Mo-SW-Dev/CalliopeMiniV2/Calliope mini rev2.0-2.1/Documentation/Datenblatt-PCB Calliope mini rev2.0.PDF

Fbl.1001-02 Kunden-Datenblatt-Leiterplatte

# Kunden-Datenblatt-Leiterplatte

### Data Sheet - PCB

### Stand: 10.02.2015

Bezeichnung / Name:
LP-Nr. / Board-Nr: Calliope mini | Bezeichnung / Name: Rev: 2.0
Art.-Nr.: DI.007.0020.0 | Datei / File: | HWB

Basis-Material / Ausführung / Laminat:
[x] FR4 | [ ] Polyimid | [ ] FR4 / Polyimid | [ ] TG:
[ ] starr / rigid | [ ] flex | [ ] starr-flex / rigid-flex | [ ] semiflex
LP-Dicke / board thicknes: | [ ] 1,0mm | [x] 1,6mm | [ ] 2,0mm | [ ] 2,4mm
Lagenzahl / Layer counts: | [ ] 1-lagig / layer | [x] 2-lagig / layers | -lagig /
[ ] layers

[ ] Signalleitungen auf Innenlagen / Signal lines on the inside
SMD-Best. / SMD-Pads: | [x] BS | [ ] LS | [ ] ohne / without
Remark : ( BS = component side = top ) ( LS = solder side = bottom ) Mechanik / Maße / Mechanic / Diameter:
[ ] Einzelplatine / single board | [x] Nutzen- 6 | fach / panel - fold | [ ] Bohrungen / drillings:
[x] gefräst / milling | [ ] geritzt / scoring
Maße Einzel / Nutzen Diameter Single / Panel 85.5 | x 75.3 | / 280.62 | x 172.24 | mm

Metallisierung (Endstärke) / Plating thickness (final thickness):
Kupfer-Endstärke / Copper thickness layer: | [x] ≥ 35µ
Kupfer-Hülse / plated through holes: | [x] ≥ 20µ

Oberfläche, Lack / Finish:
[ ] HAL bleifrei | [ ] ch. Sn ≥ 0,08µ | [x] ch. NiAu ≥ 0,05µ Au | [ ] galv. NiAu ≥ 1,27µ Au Sideplating
Lötstoplack / Soldermask: | [x] BS | [x] LS | Farbe / Colour: Blau | [ ] ohne / without
Bestückungsdruck / Component notation: | [x] BS | [x] LS | Farbe / Colour: Weiß | [ ] ohne / without
Via-Druck luftdicht / Via closed: | [ ] BS | [ ] LS | [x] ohne / without
Abdeckmaske abziehbar / Peelable mask: | [ ] BS | [ ] LS | [x] ohne / without

Prüfungen / Checks:
Leiterbild / Layout: | [x] Sichtkontrolle | [ ] AOI | [x] Elektr.-Test / electrical checks,
Kennzeichnung:
Sonstiges / other: | [ ] Schliff (bild) | [ ] Impedanzen,

Klassifizierung / Classifikation:
Leiterbreite / -abstand (µ) / kleinste Bohrung End-∅ (mm) / Lines width / -distance (µ) / smallest hole - final diameter (mm)
[ ] K1 (Normal: ≥ 8mil / 0,4mm) | [ ] K2 (Fein: ≥ 6mil / 0,3mm) | [ ] K3 (Feinst: ≥ 5mil / 0,2mm) ≥ 3mil / 0,1mm

[x] UL-Kennzeichnung und Datumskodierung / UL-marking and Date-Code

| Erstellt / made | | Geprüft / checked | | Freigegeben / released
Datum / Date: 13.06.2019 | | Datum / Date: | | Datum / Date:
Name: W. Grünwald | | Name: | | Name:

Bemerkungen / Remarks:
