Mo-SW-Dev/CalliopeMiniV2/Calliope mini rev2.0-2.1/revision Bitmap/Nummerierung.bmp

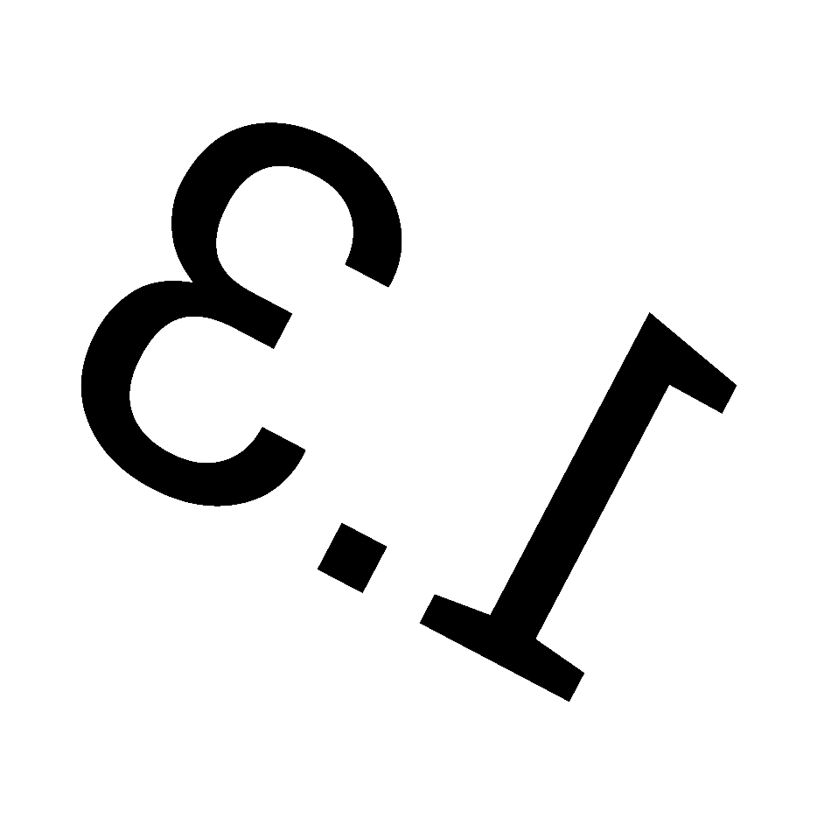
Calliope mini rev2.0-2.1/revision Bitmap/Nummerierung.bmp
