Mo-SW-Dev/CalliopeMiniV2/Calliope mini rev2.0-2.1/Silkscreen Bitmaps/Calliope_mini_1_3_Front.bmp

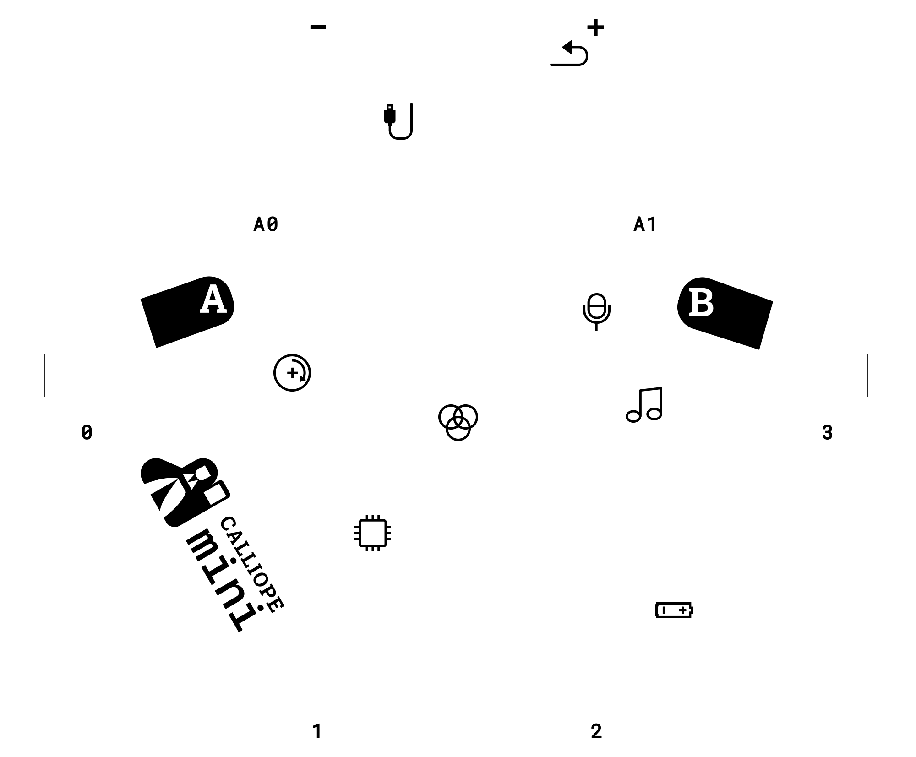
Calliope mini rev2.0-2.1/Silkscreen Bitmaps/Calliope_mini_1_3_Front.bmp
