Mo-SW-Dev/CalliopeMiniV2/Calliope mini rev2.0-2.1/Silkscreen Bitmaps/Calliope_mini_2_0_Back_VORLAGE.png

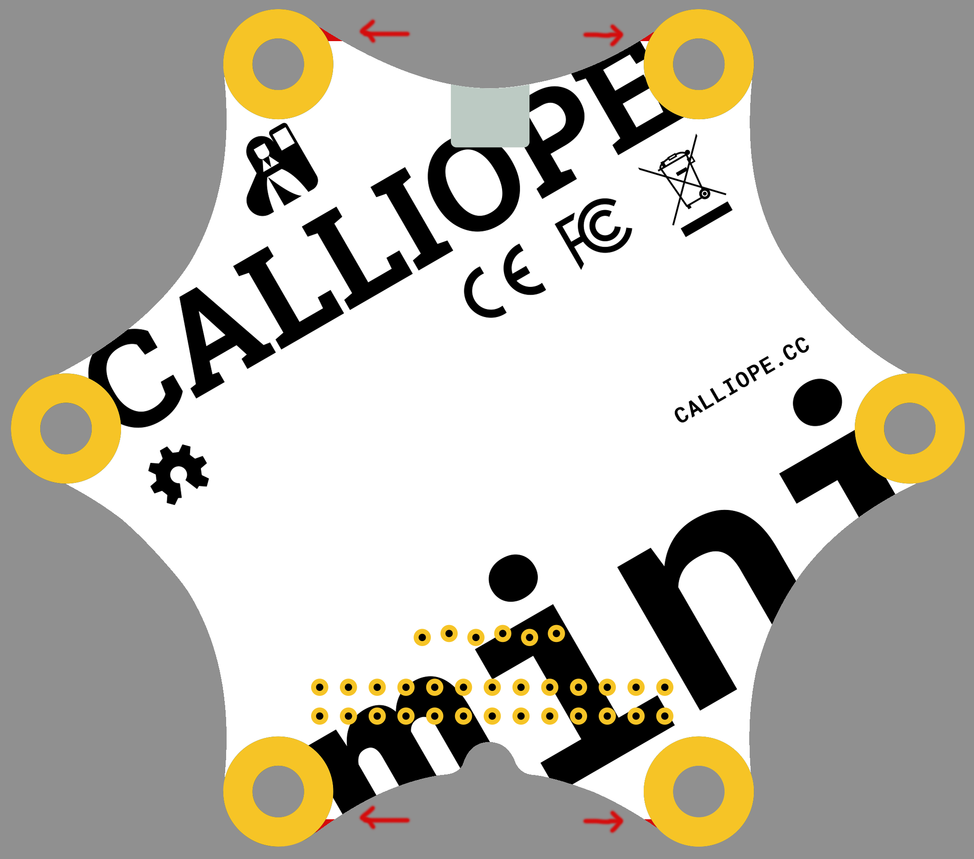
Calliope mini rev2.0-2.1/Silkscreen Bitmaps/Calliope_mini_2_0_Back_VORLAGE.png
