Mo-SW-Dev/CalliopeMiniV2/Calliope mini rev2.0-2.1/Documentation/CalliopeMiniRev2.0_TopAssembly.pdf

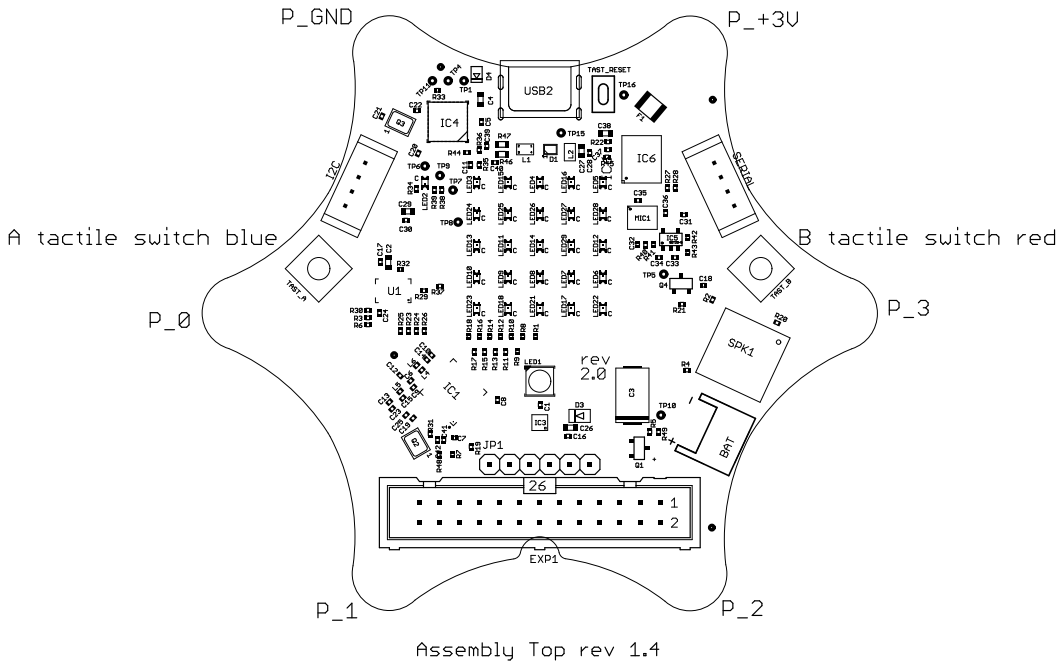
[picture p7: page 1]
