Mo-SW-Dev/CalliopeMiniV2/Calliope mini rev2.0-2.1/Documentation/CalliopeMiniRev2.0_BottomSilkscreen.pdf

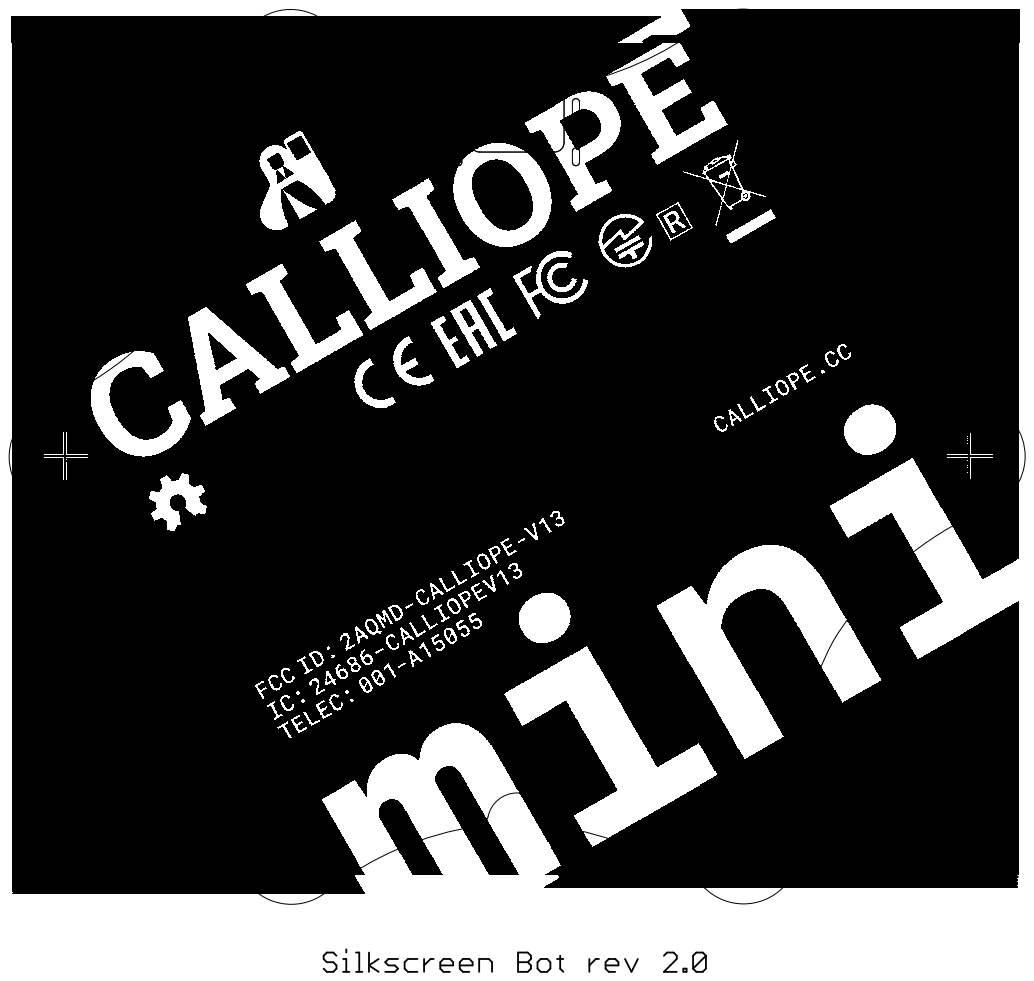
[picture p9: page 1]
