Mo-SW-Dev/CalliopeMiniV2/Calliope mini rev2.0-2.1/Documentation/CalliopeMiniRev2.0_BottomStop.pdf

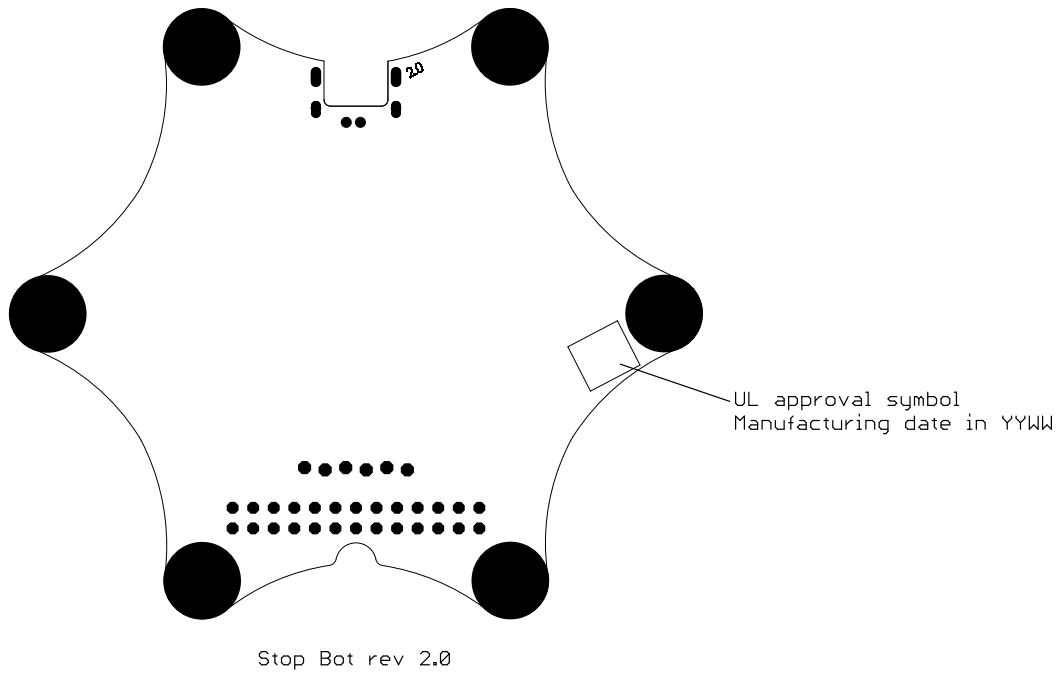
[picture p10: page 1]
