Mo-SW-Dev/CalliopeMiniV2/Calliope mini rev2.0-2.1/Documentation/CalliopeMiniRev2.0_TopSilkscreen.pdf

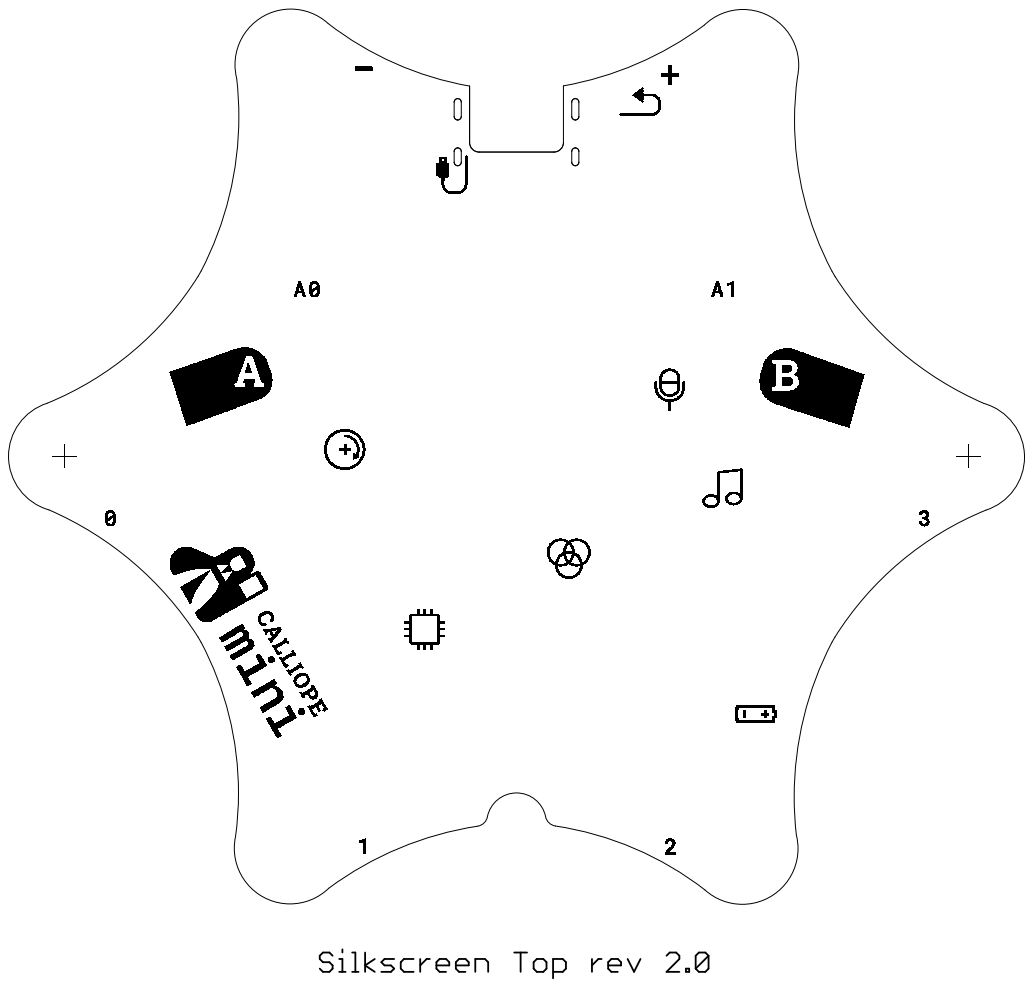
[picture p14: page 1]
