Mo-SW-Dev/CalliopeMiniV2/Calliope mini rev2.0-2.1/Calliope mini rev2.0.1.brd

## EAGLE design Calliope mini rev2.0-2.1/Calliope mini rev2.0.1.brd (2019-08-05)

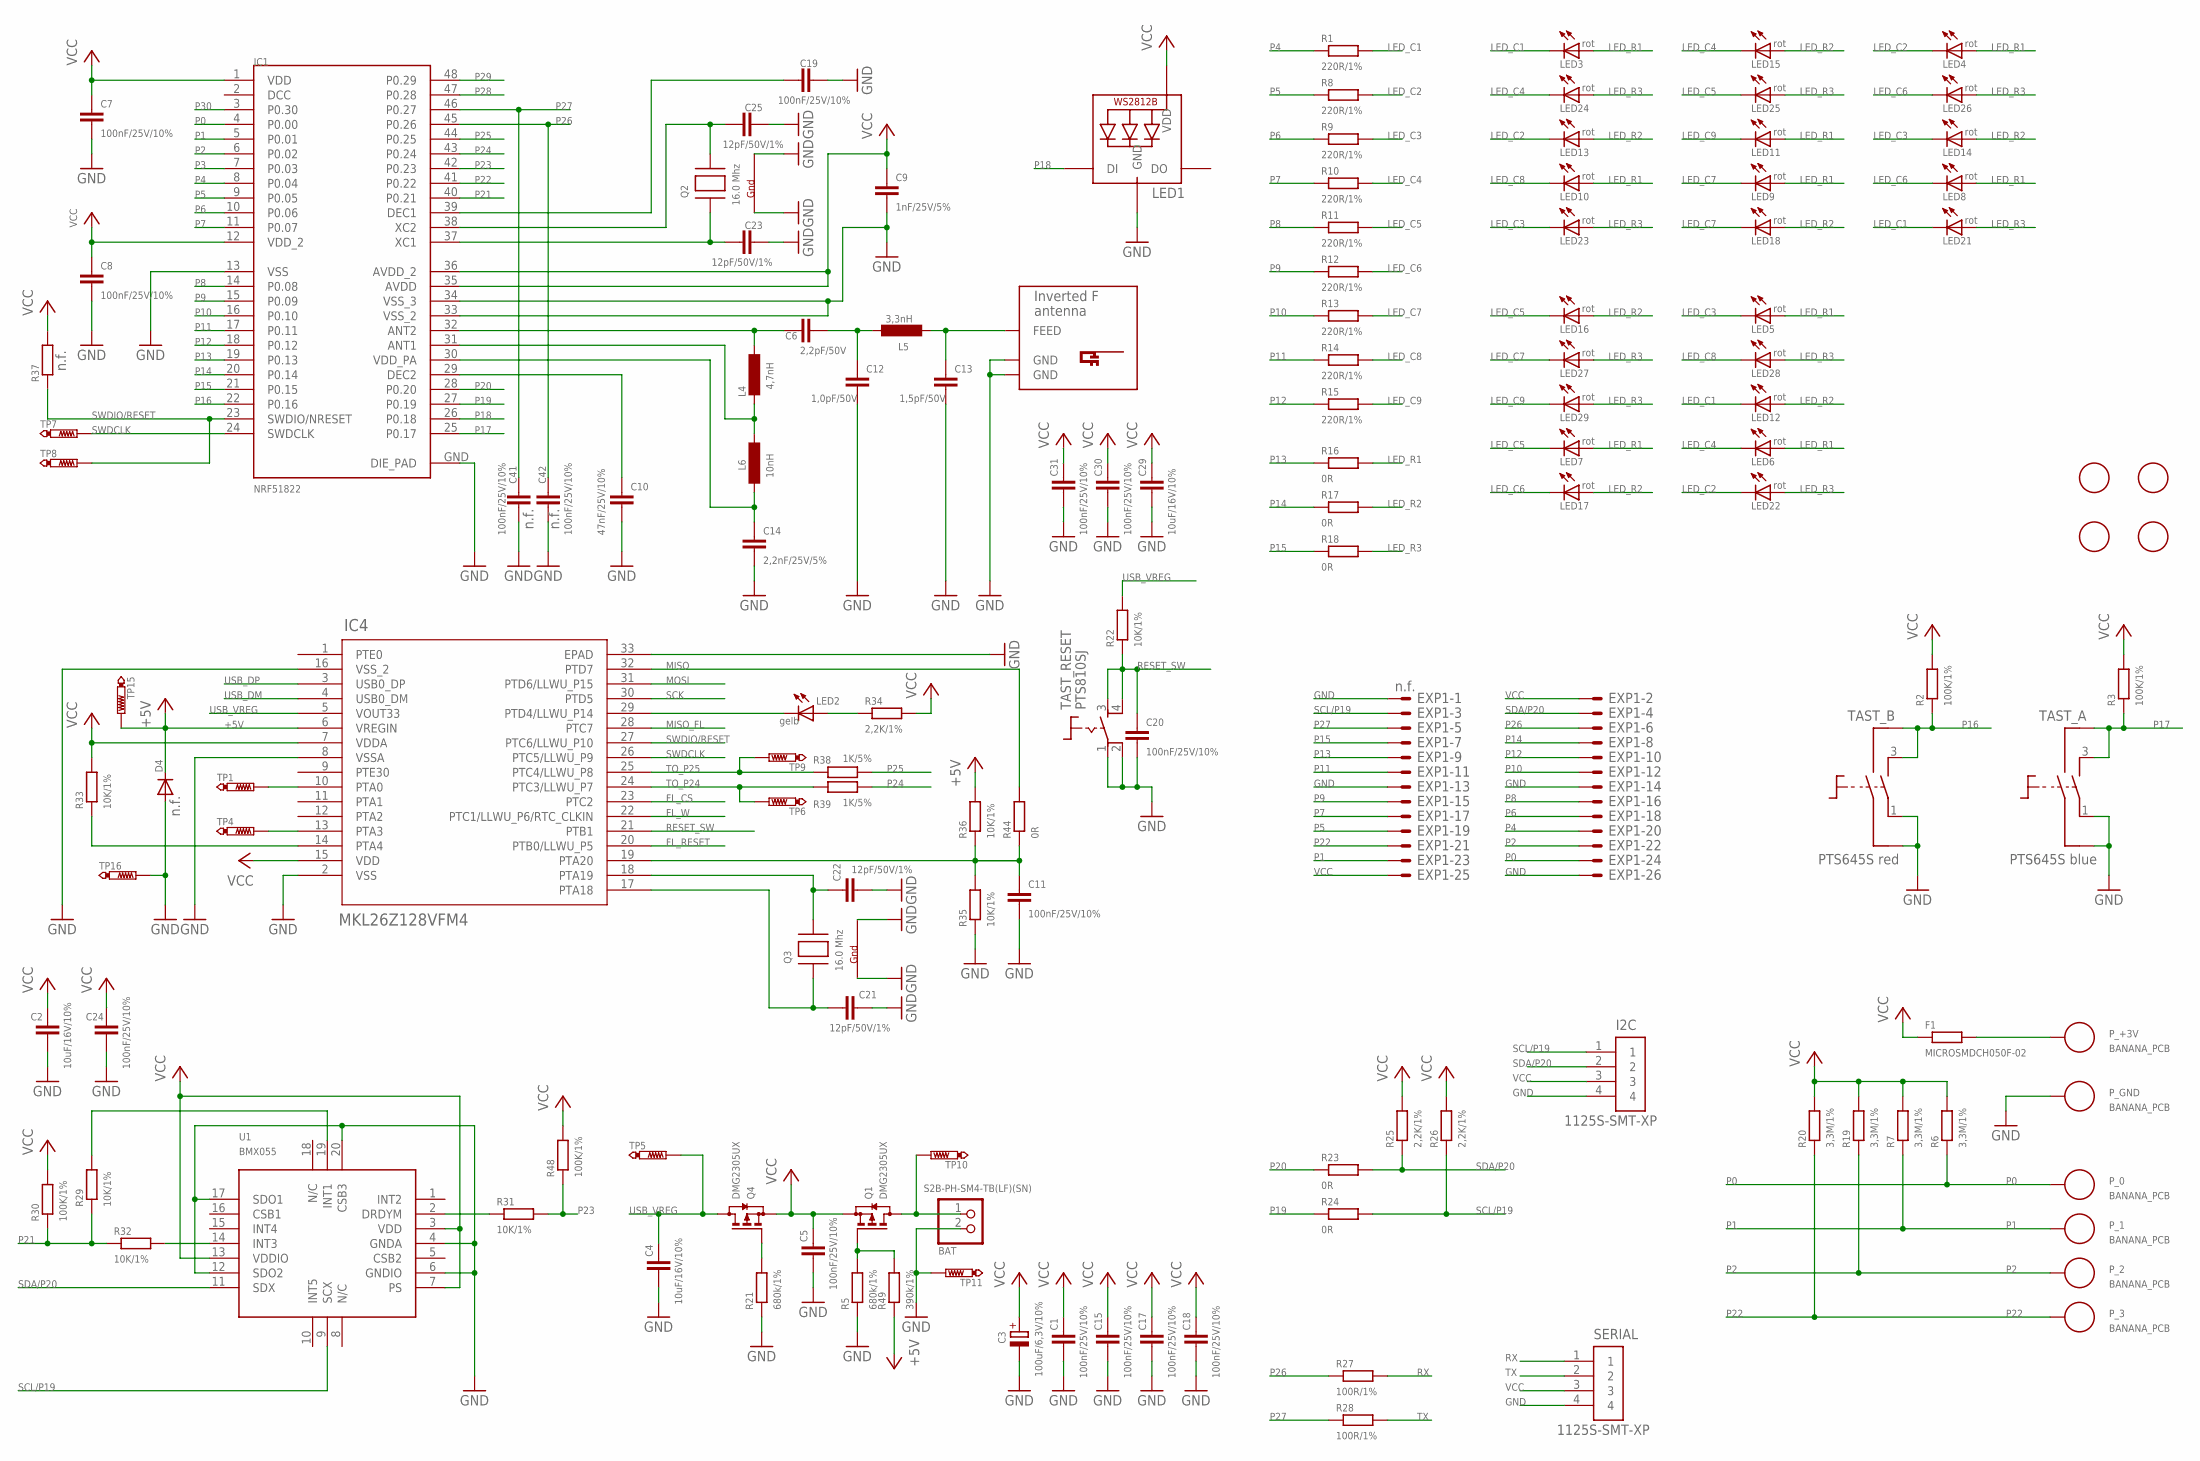
[picture p16: schematic Calliope mini rev2.0.1.sch, sheet 1]

Parts:
BAT: S2B-PH-SM4-TB(LF)(SN); JST-PH-2-SMT-RA
C1, C5, C7, C8, C11, C15, C17, C18, C19, C20, C24, C30, C31, C41, C42: 100nF/25V/10%; 0402
C2, C4, C29: 10uF/16V/10%; 0603
C3: 100uF/6,3V/10%; D/7343-31R
C6: 2,2pF/50V; 0402
C9: 1nF/25V/5%; 0402
C10: 47nF/25V/10%; 0402
C12: 1,0pF/50V; 0402
C13: 1,5pF/50V; 0402
C14: 2,2nF/25V/5%; 0402
C21, C22, C23, C25: 12pF/50V/1%; 0402
D4: DIODE-SOD323-R; SOD323-R
EXP1: ML26E; ML26
F1: MICROSMDCH050F-02; R1210
I2C: 1125S-SMT-XP
IC1: NRF51822; QFN48
IC4: MKL26Z128VFM4; QFN_32_5X5X0P9
L4: 4,7nH; 0402
L5: 3,3nH; 0402
L6: 10nH; 0402
LED1: SK6812MINI; LED3535
LED2: gelb; CHIPLED_0603
LED3, LED4, LED5, LED6, LED7, LED8, LED9, LED10, LED11, LED12, LED13, LED14, LED15, LED16, LED17, LED18, LED21, LED22, LED23, LED24, LED25, LED26, LED27, LED28, LED29: rot; CHIPLED_0603
P_0, P_1, P_2, P_3: BANANA_PCB; BANANA_REC
P_+3V: BANANA_PCB; BANANA_REC
P_GND: BANANA_PCB; BANANA_REC
Q1, Q4: DMG2305UX; SOT23
Q2, Q3: 16.0 Mhz; NX3225
R1, R8, R9, R10, R11, R12, R13, R14, R15: 220R/1%; 0402
R2, R3, R30, R48: 100K/1%; 0402
R5, R21: 680k/1%; 0402
R6, R7, R19, R20: 3,3M/1%; 0402
R16, R17, R18, R23, R24, R44: 0R; 0402
R22, R29, R31, R32, R33, R35, R36: 10K/1%; 0402
R25, R26, R34: 2,2K/1%; 0402
R27, R28: 100R/1%; 0402
R37: R-EU_0402; 0402
R38, R39: 1K/5%; 0402
R49: 390k/1%; 0402
SERIAL: 1125S-SMT-XP
TAST_A: PTS645S blue; PTS645S
TAST_B: PTS645S red; PTS645S
TAST_RESET: PTS810SJ; PTS810
TP1, TP4, TP5, TP6, TP7, TP8, TP9, TP10, TP11, TP15, TP16: PTR1B1,27; B1,27
U1: BMX055
U$2: INVERTED_F_ANTENNA; DN0007+0_MIRROR
U$5, U$6, U$7, U$8: FIDUCIAL; FIDUCIAL_1MM

Connections:
+5V: D4.C, IC4.6 (VREGIN), R36.2, R49.1, TP15.TP; also elsewhere on the board
FL_CS: IC4.23 (PTC2); also elsewhere on the board
FL_RESET: IC4.20 (PTB0/LLWU_P5); also elsewhere on the board
FL_W: IC4.22 (PTC1/LLWU_P6/RTC_CLKIN); also elsewhere on the board
GND: BAT.2 (1), C1.2, C2.2, C3.-, C4.2, C5.2, C7.2, C8.2, C9.2, C10.2, C11.2, C12.2, C13.2, C14.2, C15.2, C17.2, C18.2, C19.2, C20.2, C21.2, C22.2, C23.2, C24.2, C25.2, C29.2, C30.2, C31.2, C41.2, C42.2, D4.A, EXP1.1, EXP1.13, EXP1.14, EXP1.26, I2C.4, IC1.13 (VSS), IC1.33 (VSS_2), IC1.34 (VSS_3), IC1.GND (DIE_PAD), IC4.2 (VSS), IC4.8 (VSSA), IC4.16 (VSS_2), IC4.33 (EPAD), LED1.4 (GND), P_GND.1, Q2.2 (G2), Q2.4 (G1), Q3.2 (G2), Q3.4 (G1), R5.1, R21.1, R35.1, SERIAL.4, TAST_A.1, TAST_A.2, TAST_B.1, TAST_B.2, TAST_RESET.1, TAST_RESET.2 (P1), TP11.TP, TP16.TP, U1.4 (GNDA), U1.6 (GNDIO), U1.12 (SDO2), U1.17 (SDO1), U1.20 (CSB3), U$2.GND, U$2.GND@1 (GND); also elsewhere on the board
LED_C1: LED3.A, LED12.A, LED21.A, R1.2
LED_C2: LED4.A, LED13.A, LED22.A, R8.2
LED_C3: LED5.A, LED14.A, LED23.A, R9.2
LED_C4: LED6.A, LED15.A, LED24.A, R10.2
LED_C5: LED7.A, LED16.A, LED25.A, R11.2
LED_C6: LED8.A, LED17.A, LED26.A, R12.2
LED_C7: LED9.A, LED18.A, LED27.A, R13.2
LED_C8: LED10.A, LED28.A, R14.2
LED_C9: LED11.A, LED29.A, R15.2
LED_R1: LED3.C, LED4.C, LED5.C, LED6.C, LED7.C, LED8.C, LED9.C, LED10.C, LED11.C, R16.2
LED_R2: LED12.C, LED13.C, LED14.C, LED15.C, LED16.C, LED17.C, LED18.C, R17.2
LED_R3: LED21.C, LED22.C, LED23.C, LED24.C, LED25.C, LED26.C, LED27.C, LED28.C, LED29.C, R18.2
MISO: IC4.32 (PTD7), R44.2; also elsewhere on the board
MISO_FL: IC4.28 (PTC7); also elsewhere on the board
MOSI: IC4.31 (PTD6/LLWU_P15); also elsewhere on the board
unnamed: C25.1, IC1.38 (XC2), Q2.3 (X2)
unnamed: R29.2, U1.19 (INT1)
unnamed: IC4.14 (PTA4), R33.1
unnamed: IC4.29 (PTD4/LLWU_P14), LED2.A
unnamed: R32.2, U1.14 (INT3)
unnamed: Q1.1 (G), R5.2, R49.2
unnamed: LED2.C, R34.1
unnamed: F1.2, P_+3V.1
unnamed: C22.1, IC4.18 (PTA19), Q3.3 (X2)
unnamed: C23.1, IC1.37 (XC1), Q2.1 (X1)
unnamed: C14.1, IC1.30 (VDD_PA), L6.1
unnamed: C6.1, IC1.32 (ANT2), L4.1
unnamed: C6.2, C12.1, L5.1
unnamed: C13.1, L5.2, U$2.FEED
unnamed: IC1.31 (ANT1), L4.2, L6.2
unnamed: C19.1, IC1.39 (DEC1)
unnamed: C21.1, IC4.17 (PTA18), Q3.1 (X1)
unnamed: Q4.1 (G), R21.2
unnamed: C10.1, IC1.29 (DEC2)
unnamed: R31.1, U1.2 (DRDYM)
unnamed: C11.1, IC4.19 (PTA20), R35.2, R36.1, R44.1
P0: EXP1.24, IC1.4 (P0.00), P_0.1, R6.1
P1: EXP1.23, IC1.5 (P0.01), P_1.1, R7.1
P2: EXP1.22, IC1.6 (P0.02), P_2.1, R19.1
P3: IC1.7 (P0.03); also elsewhere on the board
P4: EXP1.20, IC1.8 (P0.04), R1.1
P5: EXP1.19, IC1.9 (P0.05), R8.1
P6: EXP1.18, IC1.10 (P0.06), R9.1
P7: EXP1.17, IC1.11 (P0.07), R10.1
P8: EXP1.16, IC1.14 (P0.08), R11.1
P9: EXP1.15, IC1.15 (P0.09), R12.1
P10: EXP1.12, IC1.16 (P0.10), R13.1
P11: EXP1.11, IC1.17 (P0.11), R14.1
P12: EXP1.10, IC1.18 (P0.12), R15.1
P13: EXP1.9, IC1.19 (P0.13), R16.1
P14: EXP1.8, IC1.20 (P0.14), R17.1
P15: EXP1.7, IC1.21 (P0.15), R18.1
P16: IC1.22 (P0.16), R2.1, TAST_B.3 (S1), TAST_B.4 (S2)
P17: IC1.25 (P0.17), R3.1, TAST_A.3 (S1), TAST_A.4 (S2)
P18: IC1.26 (P0.18), LED1.1 (DI)
P19: IC1.27 (P0.19), R24.1
P20: IC1.28 (P0.20), R23.1
P21: IC1.40 (P0.21), R29.1, R30.1, R32.1
P22: EXP1.21, IC1.41 (P0.22), P_3.1, R20.1
P23: IC1.42 (P0.23), R31.2, R48.1
P24: IC1.43 (P0.24), R39.2
P25: IC1.44 (P0.25), R38.2
P26: C42.1, EXP1.6, IC1.45 (P0.26), R27.1
P27: C41.1, EXP1.5, IC1.46 (P0.27), R28.1
P28: IC1.47 (P0.28); also elsewhere on the board
P29: IC1.48 (P0.29); also elsewhere on the board
P30: IC1.3 (P0.30); also elsewhere on the board
RESET_SW: C20.1, IC4.21 (PTB1), R22.1, TAST_RESET.3 (S), TAST_RESET.4 (S1)
RX: R27.2, SERIAL.1
SCK: IC4.30 (PTD5); also elsewhere on the board
SCL/P19: EXP1.3, I2C.1, R24.2, R26.1, U1.9 (SCX)
SDA/P20: EXP1.4, I2C.2, R23.2, R25.1, U1.11 (SDX)
SWCLK: IC4.10 (PTA0), TP1.TP
SWDCLK: IC1.24 (SWDCLK), IC4.26 (PTC5/LLWU_P9), TP7.TP
SWDIO: IC4.13 (PTA3), TP4.TP
SWDIO/RESET: IC1.23 (SWDIO/NRESET), IC4.27 (PTC6/LLWU_P10), R37.1, TP8.TP
TO_P24: IC4.24 (PTC3/LLWU_P7), R39.1, TP6.TP
TO_P25: IC4.25 (PTC4/LLWU_P8), R38.1, TP9.TP
TX: R28.2, SERIAL.2
USB_DM: IC4.4 (USB0_DM); also elsewhere on the board
USB_DP: IC4.3 (USB0_DP); also elsewhere on the board
USB_VREG: C4.1, IC4.5 (VOUT33), Q4.3 (D), R22.2, TP5.TP
VCC: C1.1, C2.1, C3.+, C5.1, C7.1, C8.1, C9.1, C15.1, C17.1, C18.1, C24.1, C29.1, C30.1, C31.1, EXP1.2, EXP1.25, F1.1, I2C.3, IC1.1 (VDD), IC1.12 (VDD_2), IC1.35 (AVDD), IC1.36 (AVDD_2), IC4.7 (VDDA), IC4.15 (VDD), LED1.2 (VDD), Q1.2 (S), Q4.2 (S), R2.2, R3.2, R6.2, R7.2, R19.2, R20.2, R25.2, R26.2, R30.2, R33.2, R34.2, R37.2, R48.2, SERIAL.3, U1.3 (VDD), U1.7 (PS), U1.13 (VDDIO); also elsewhere on the board
VIN: BAT.1 (2), Q1.3 (D), TP10.TP

Notes on the sheet:
LED1

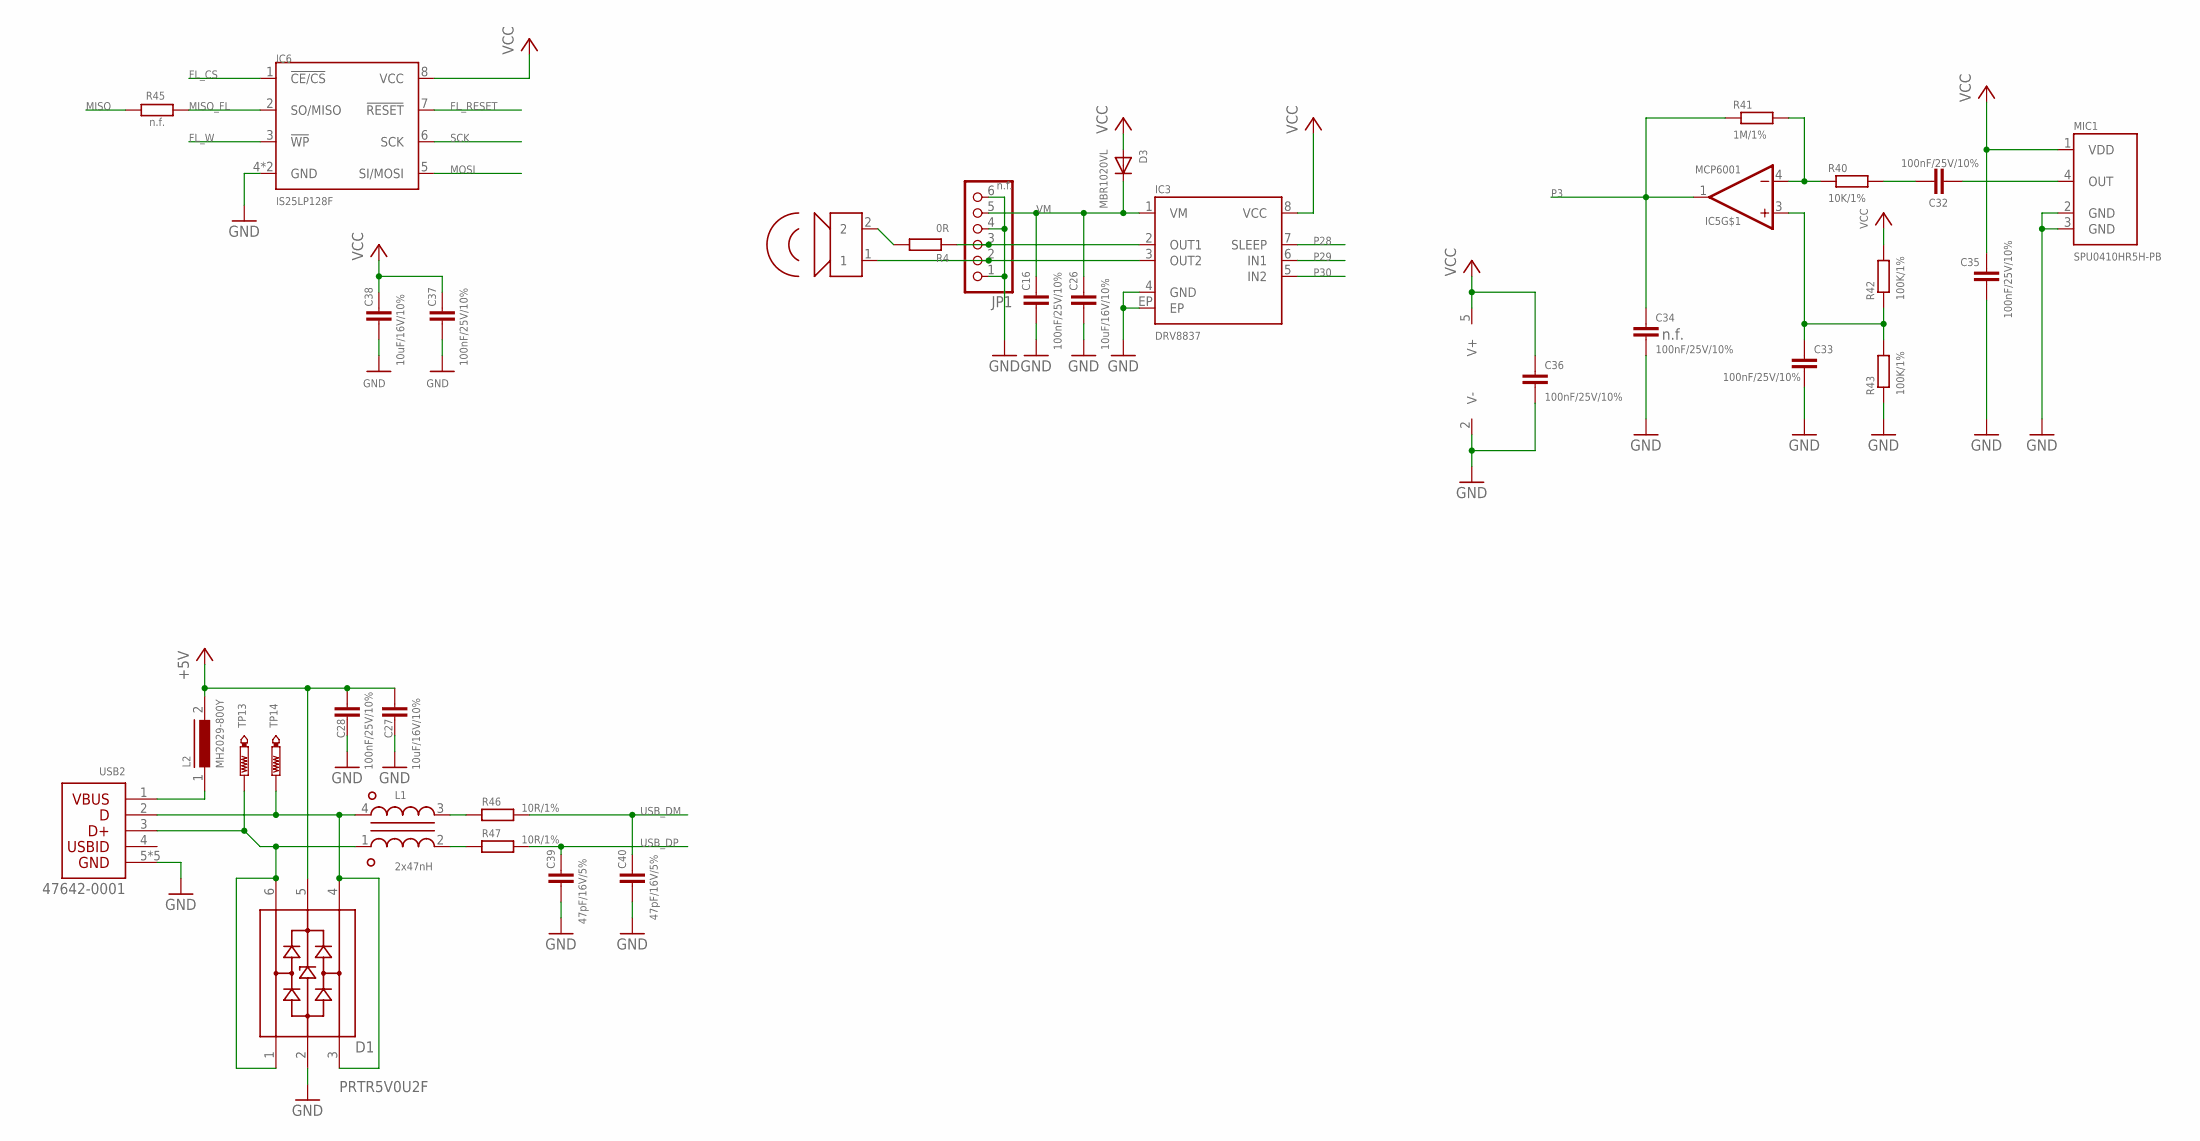
[picture p17: schematic Calliope mini rev2.0.1.sch, sheet 2]

Parts:
C16, C28, C32, C33, C34, C35, C36, C37: 100nF/25V/10%; 0402
C26, C27, C38: 10uF/16V/10%; 0603
C39, C40: 47pF/16V/5%; 0402
D1: PRTR5V0U2F; SOT886
D3: MBR1020VL; SOD-123FL
IC3: DRV8837; WSON8
IC5: MCP6001; SOT23-5
IC6: IS25LP128F; VQFN8_6X5
JP1: PINHD-1X6-OFF; 1X06-OFF
L1: 2x47nH; USB_2.0_FILTER_0805
L2: MH2029-800Y; FERRIT_0805
MIC1: SPU0410HR5H-PB
R4: 0R; 0402
R40: 10K/1%; 0402
R41: 1M/1%; 0402
R42, R43: 100K/1%; 0402
R45: 100R/1%; 0402
R46, R47: 10R/1%; R0603
SPK1: PKMCS0909E4000-R1; PKMCS
TP13, TP14: PTR1B1,27; B1,27
USB2: 47642-0001

Connections:
+5V: C27.1, C28.1, D1.5, L2.2; also elsewhere on the board
FL_CS: IC6.1 (!CE/CS); also elsewhere on the board
FL_RESET: IC6.7 (!RESET); also elsewhere on the board
FL_W: IC6.3 (!WP); also elsewhere on the board
GND: C16.2, C26.2, C27.2, C28.2, C33.2, C34.2, C35.2, C36.2, C37.2, C38.2, C39.2, C40.2, D1.2, IC3.4 (GND), IC3.EP, IC5.2 (V-), IC6.4 (GND), IC6.EP (GND), JP1.1, JP1.4, JP1.6, MIC1.2 (GND), MIC1.3 (GND), R43.1, USB2.5, USB2.P$1 (5), USB2.P$2 (5), USB2.P$3 (5), USB2.P$4 (5); also elsewhere on the board
MISO: R45.1; also elsewhere on the board
MISO_FL: IC6.2 (SO/MISO), R45.2; also elsewhere on the board
MOSI: IC6.5 (SI/MOSI); also elsewhere on the board
unnamed: IC3.3 (OUT2), JP1.2, SPK1.1
unnamed: IC3.2 (OUT1), JP1.3, R4.1
unnamed: R4.2, SPK1.2
unnamed: C33.1, IC5.3 (+IN), R42.1, R43.2
unnamed: L2.1, USB2.1
unnamed: D1.1, D1.6, L1.1, TP13.TP, USB2.3
unnamed: D1.3, D1.4, L1.4 (2), TP14.TP, USB2.2
unnamed: IC5.4 (-IN), R40.1, R41.2
unnamed: C32.1, R40.2
unnamed: C32.2, MIC1.4 (OUT)
unnamed: L1.3 (4), R46.1
unnamed: L1.2 (3), R47.1
P3: C34.1, IC5.1 (OUT), R41.1; also elsewhere on the board
P28: IC3.7 (SLEEP); also elsewhere on the board
P29: IC3.6 (IN1); also elsewhere on the board
P30: IC3.5 (IN2); also elsewhere on the board
SCK: IC6.6 (SCK); also elsewhere on the board
USB_DM: C40.1, R46.2; also elsewhere on the board
USB_DP: C39.1, R47.2; also elsewhere on the board
VCC: C35.1, C36.1, C37.1, C38.1, D3.A, IC3.8 (VCC), IC5.5 (V+), IC6.8 (VCC), MIC1.1 (VDD), R42.2; also elsewhere on the board
VM: C16.1, C26.1, D3.C, IC3.1 (VM), JP1.5

Notes on the sheet:
n.f.

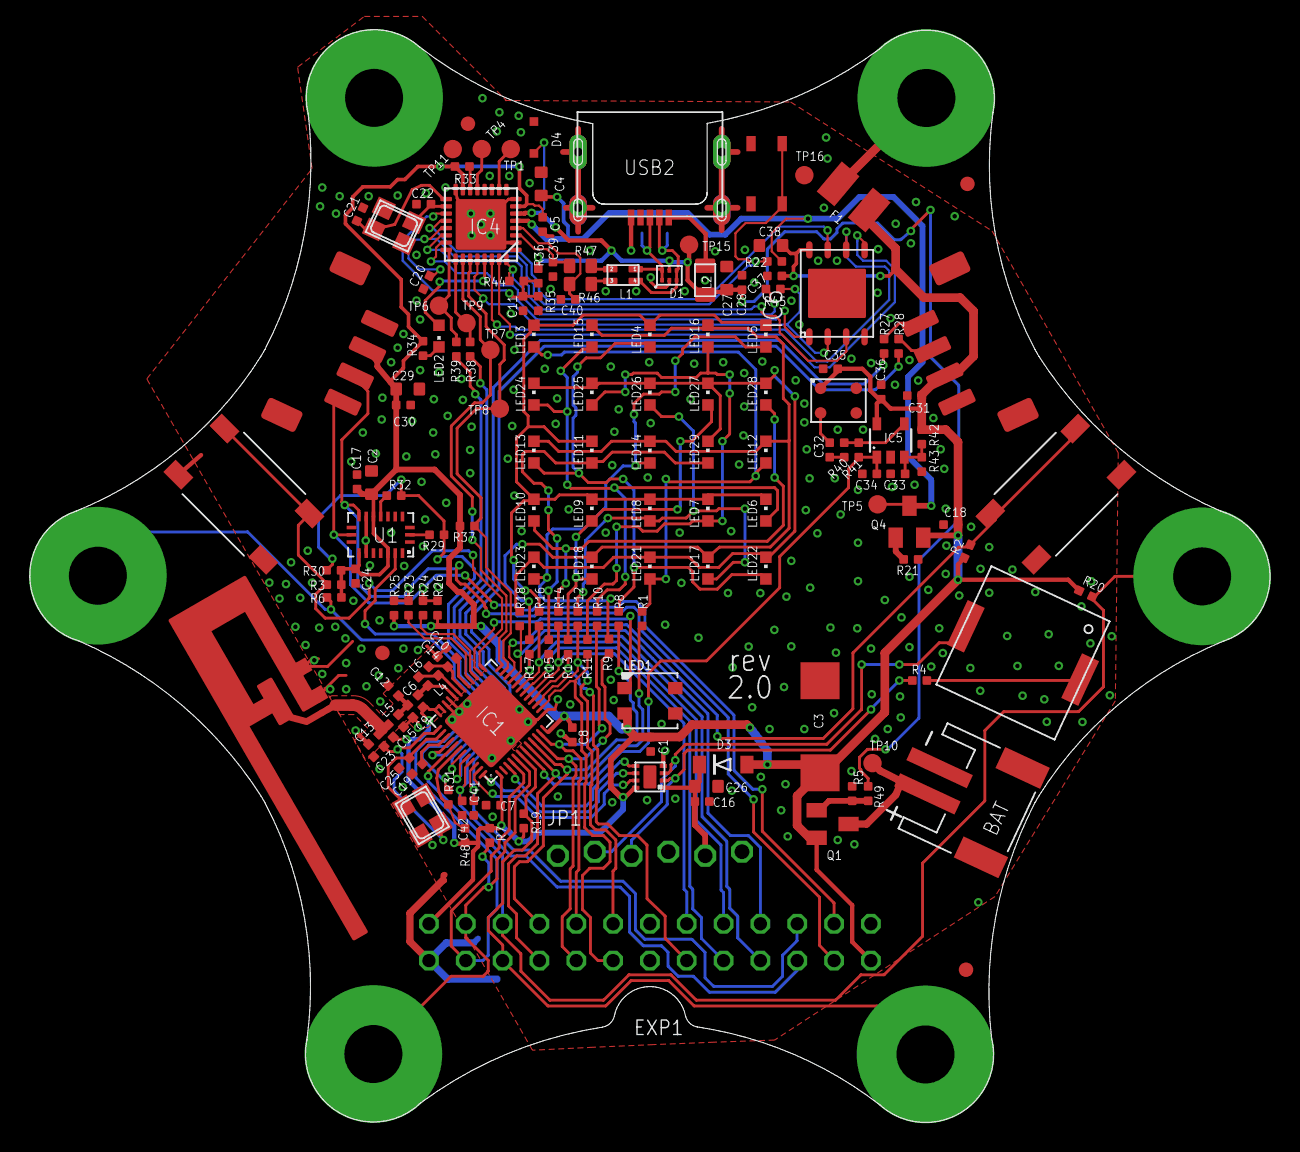
[picture p18: board Calliope mini rev2.0.1.brd from above]

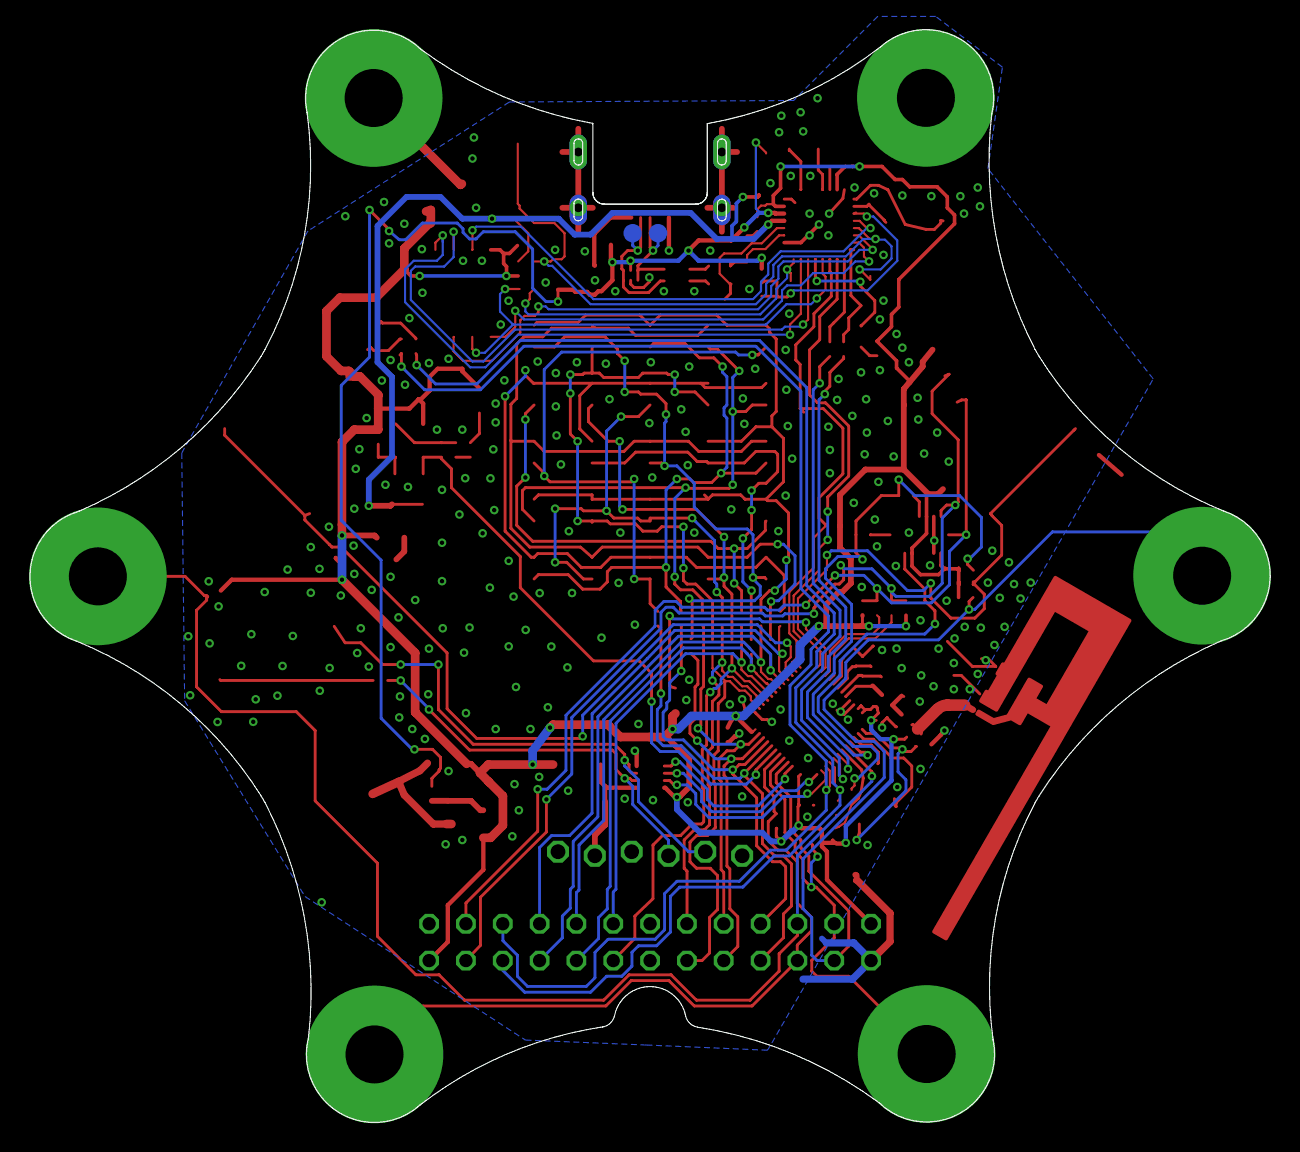
[picture p19: board Calliope mini rev2.0.1.brd from below]

Board: 2 copper layers, 85.5 x 75.4 mm, 172 parts (3 on the bottom side), 102 nets.
